tanatolog/floating-point-divider/documentation.pdf

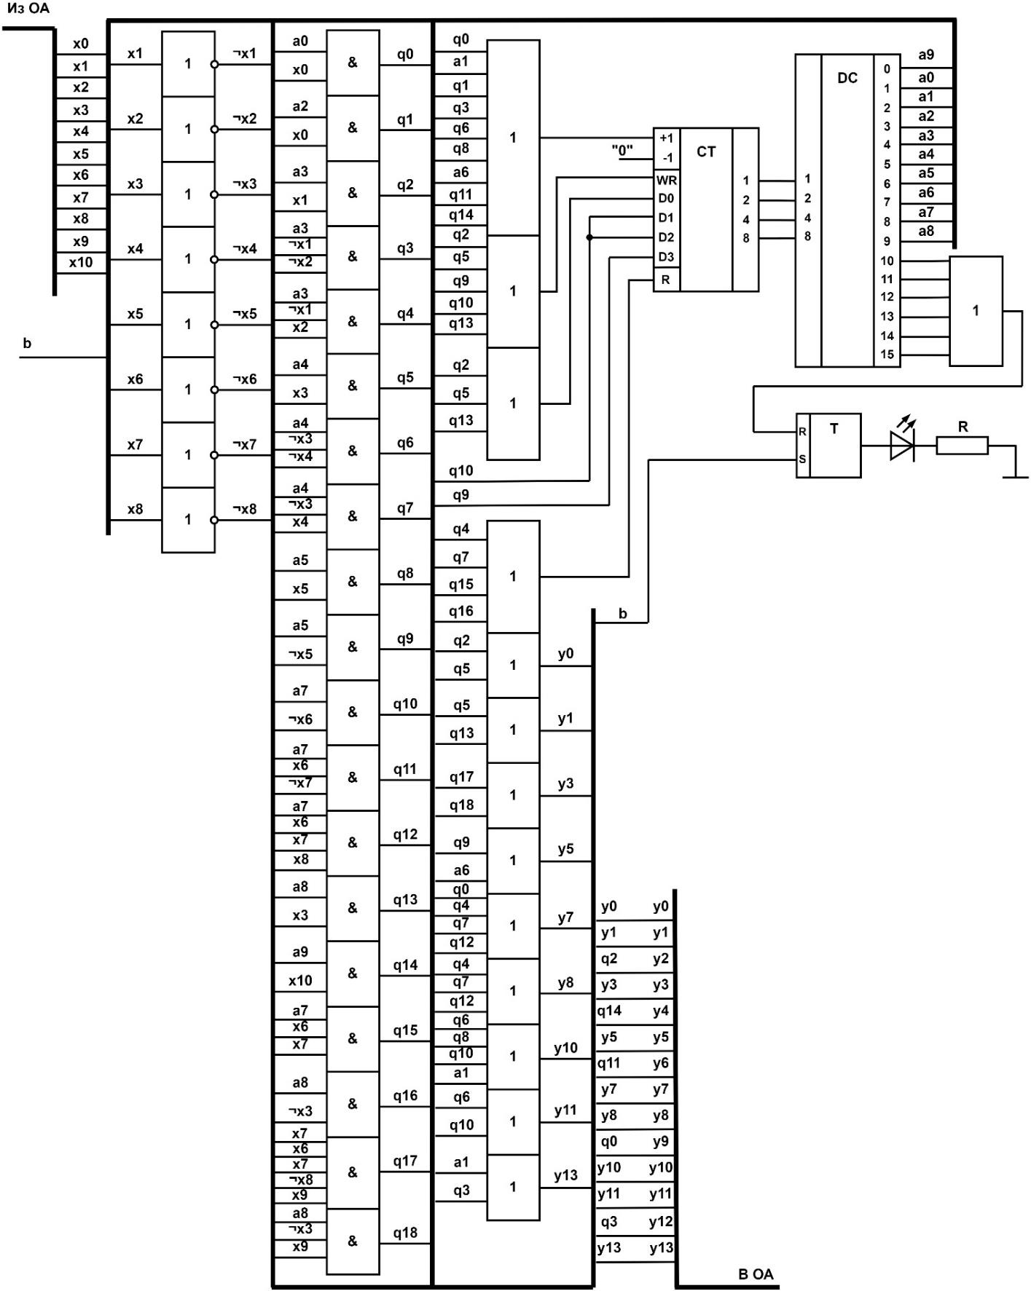
[picture p10: figure]
